Puyb/powermeter/README.md

Do It Yourself (DIY) Cycle Power Meter

Based on https://gitlab.com/tbressers/power/ with a custom PCB in the hardware folder

---

Original README:

This is the code for a crank-based power meter, transmitting over BLE to a bike computer. The whole project is based on Steve Jarvis website/gitlab with a nice set of improvements (see gitlab link below) and tested on a 'Adafruit Bluefruit nRF52840 Feather Express' board.

Please find the complete DIY work-instruction here:

https://gitlab.com/tbressers/power/-/wikis/home

Best regards,
Thijs
