Puyb/powermeter/hardware/Datasheets.md

[Seeedstudio XIA BLE](https://wiki.seeedstudio.com/XIAO_BLE/)

[Seeedstudio XIA BLE schematics](https://files.seeedstudio.com/wiki/XIAO-BLE/Seeed-Studio-XIAO-nRF52840-Sense-v1.1.pdf)

[nRF52840](https://files.seeedstudio.com/wiki/XIAO-BLE/nRF52840_PS_v1.5.pdf)

[HX711](https://cdn.sparkfun.com/datasheets/Sensors/ForceFlex/hx711_english.pdf)

[MPU-6050](https://invensense.tdk.com/wp-content/uploads/2015/02/MPU-6000-Datasheet1.pdf)

[MPU-6050 Register map](https://invensense.tdk.com/wp-content/uploads/2015/02/MPU-6000-Register-Map1.pdf)

[LSM6DS3TR-C](https://datasheet.lcsc.com/lcsc/2102261805_STMicroelectronics-LSM6DS3TR-C_C967633.pdf)
