Puyb/powermeter/hardware/powermeter.pdf

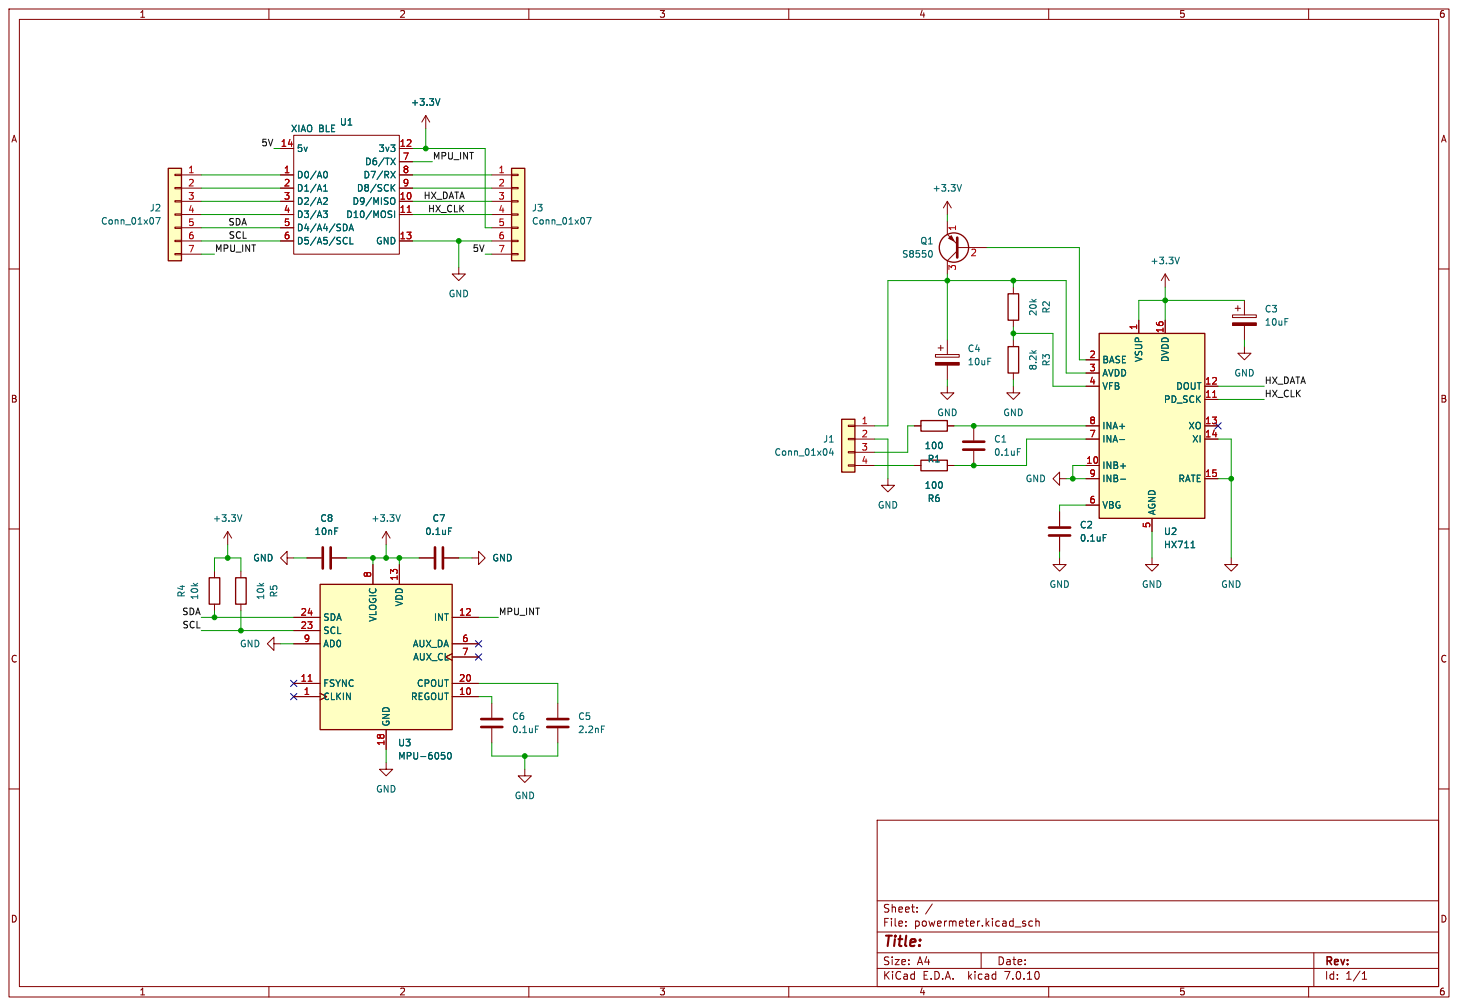
[picture p1: page 1]

Id: 1/1 Title: File: powermeter.kicad_sch Sheet: /
