Puyb/powermeter/hardware/powermeter.kicad_pcb

## KiCad design hardware/powermeter.kicad_pcb (2024-01-20)

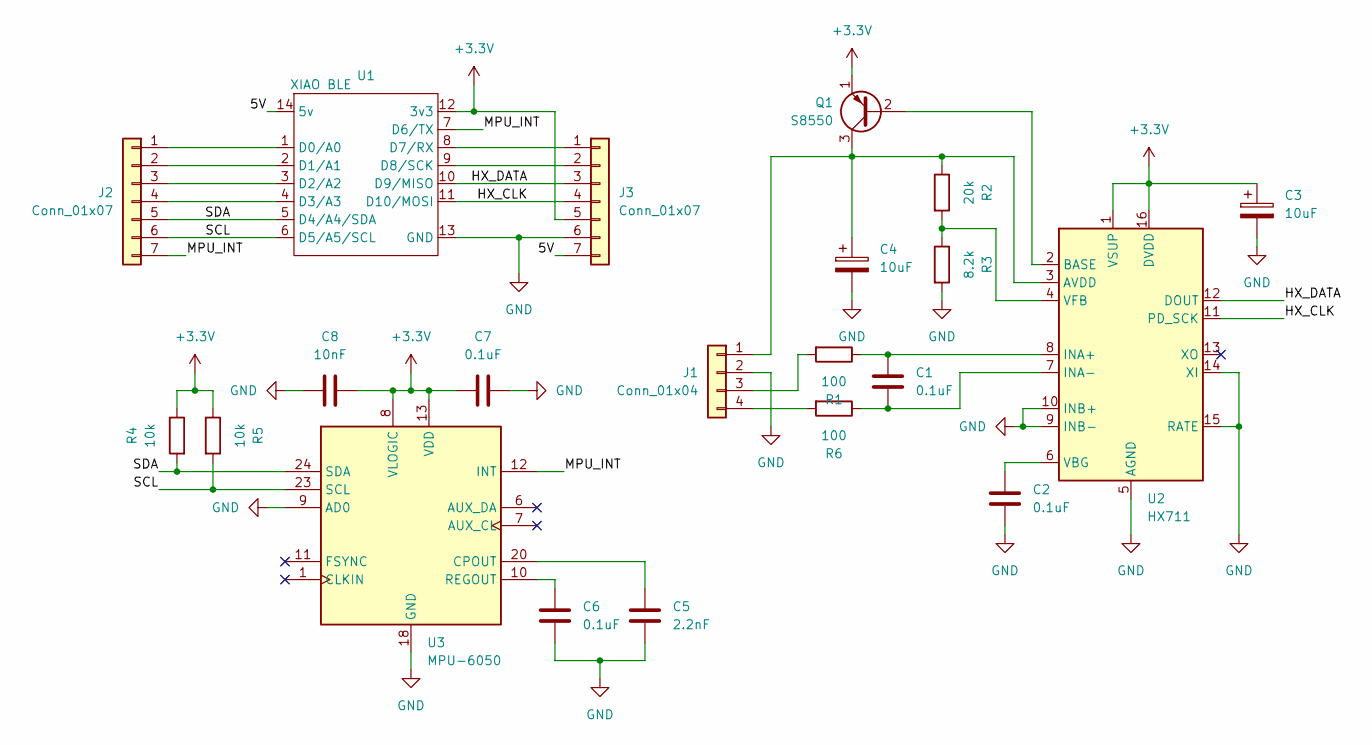
[picture p2: schematic powermeter.kicad_sch]

Parts:
C1, C2, C6, C7: 0.1uF; C_0402_1005Metric; LCSC C1525
C3, C4: 10uF; C_0402_1005Metric; LCSC C15525
C5: 2.2nF; C_0402_1005Metric; LCSC C1604
C8: 10nF; C_0402_1005Metric; LCSC C15195
J1: Conn_01x04; connecteur
J2, J3: Conn_01x07; PinHeader_1x07_P2.54mm_Vertical
Q1: S8550; SOT-23; LCSC C105432
R1, R6: 100; R_0402_1005Metric; LCSC C25076
R2: 20k; R_0402_1005Metric; LCSC C25765
R3: 8.2k; R_0402_1005Metric; LCSC C2906967
R4, R5: 10k; R_0402_1005Metric; LCSC C25744
U1: XIAO BLE; MOUDLE16P-SMD-2.54-21X17.8MM
U2: HX711; SOP-16_3.9x9.9mm_P1.27mm; LCSC C6705483
U3: MPU-6050; InvenSense_QFN-24_4x4mm_P0.5mm; LCSC C24112

Connections:
+3.3V: C3.1, C7.1, C8.1, J3.5, Q1.1 (E), R4.1, R5.1, U1.12 (3v3), U2.1 (VSUP), U2.16 (DVDD), U3.8 (VLOGIC), U3.13 (VDD)
/5V: J3.7, U1.14 (5v)
/HX_CLK: J3.4, U1.11 (D10/MOSI), U2.11 (PD_SCK)
/HX_DATA: J3.3, U1.10 (D9/MISO), U2.12 (DOUT)
/MPU_INT: J2.7, U1.7 (D6/TX), U3.12 (INT)
/SCL: J2.6, R5.2, U1.6 (D5/A5/SCL), U3.23 (SCL)
/SDA: J2.5, R4.2, U1.5 (D4/A4/SDA), U3.24 (SDA)
GND: C2.2, C3.2, C4.2, C5.2, C6.2, C7.2, C8.2, J1.2, J3.6, R3.2, U1.13 (GND), U2.5 (AGND), U2.9 (INB-), U2.10 (INB+), U2.14 (XI), U2.15 (RATE), U3.9 (AD0), U3.18 (GND)
unnamed: C4.1, J1.1, Q1.3 (C), R2.1, U2.3 (AVDD)
unnamed: J1.3, R1.2
unnamed: J1.4, R6.2
unnamed: J2.1, U1.1 (D0/A0)
unnamed: J2.2, U1.2 (D1/A1)
unnamed: J2.3, U1.3 (D2/A2)
unnamed: J2.4, U1.4 (D3/A3)
unnamed: J3.1, U1.8 (D7/RX)
unnamed: J3.2, U1.9 (D8/SCK)
unnamed: Q1.2 (B), U2.2 (BASE)
unnamed: C1.1, R1.1, U2.8 (INA+)
unnamed: C1.2, R6.1, U2.7 (INA-)
unnamed: C2.1, U2.6 (VBG)
unnamed: R2.2, R3.1, U2.4 (VFB)
unnamed: C5.1, U3.20 (CPOUT)
unnamed: C6.1, U3.10 (REGOUT)

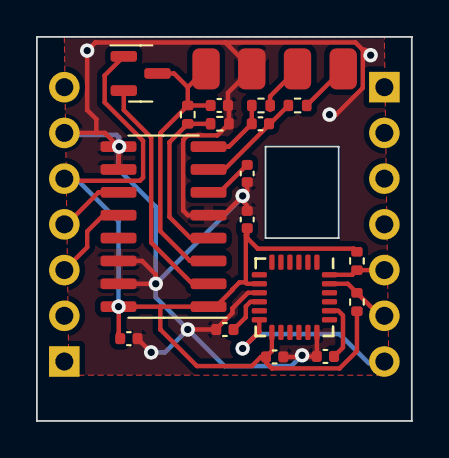
[picture p3: board powermeter.kicad_pcb from above]

Board: 2 copper layers, 20.8 x 21.3 mm, 21 parts (1 on the bottom side), 24 nets.
