Puyb/powermeter/(commit log)

2021-11-05 Initial commit, copied files from Steve Jarvis and added sleep mode for Feather Express boards https://iamteapot.dev/homemade-power-meter/ https://gitlab.com/sjarvis/powermeter
    TODO:
    - Cleanup code
    - Integrate calibration
    - Many more things!
2021-11-12 Added sleep and wake-up, and started the semi- automatic calibration implementation
2021-11-12 Sleep / wake-up and semi-automatic calibration
2021-11-16 Upgrade to latest board and library versions
2021-11-19 Calibration via bluetooth (Bluefruit LE connect App)
2021-11-21 Added storage of calibration factor in UICR on nRF52840 (feather)
2021-11-26 Fixed calibration saving to nvram (flash)
    [calibrate.ino, power.ino]
2021-12-13 Interrupt driven load cell reading
2021-12-17 Fixed kg to Newtons
    [gyro.ino, load_cell.ino, power.ino]
2021-12-17 Fixed battery reading
2021-12-18 abs power and smart calibration
2021-12-28 Workaround for load-sensor calibration/read-out
    [calibrate.ino, load_cell.ino, power.ino]
2021-12-29 Calibration fix/workaround
2021-12-29 Fixed calibration values saving
    [calibrate.ino, load_cell.ino]
2021-12-29 Fixed calibrations value saving
2021-12-30 Properly fixed x2 issue
    [calibrate.ino, power.ino]
2022-01-12 Fixed cadence and increased measurement robustness
    [gyro.ino, power.ino]
2022-01-12 Added temperature and session stats
2022-01-27 Gyroscope-speed based cadence measurements
2023-12-28 First version
    [powermeter-CuBottom.gbr, powermeter-CuTop.gbr, powermeter-EdgeCuts.gbr, powermeter-MaskBottom.gbr, powermeter-MaskTop.gbr, powermeter-NPTH.drl, powermeter-PTH.drl, powermeter-PasteBottom.gbr]
2023-12-28 Fix 5v-GND short. Minor tweaks on layout
    [powermeter.kicad_pcb, powermeter.kicad_sch]
2024-01-20 Fix AD0 MPU6050 to GND
    [powermeter.kicad_pcb, powermeter.kicad_sch]
2024-01-21 Move kicad files to hardware
    [powermeter-CuBottom.gbr, powermeter-CuTop.gbr, powermeter-EdgeCuts.gbr, powermeter-MaskBottom.gbr, powermeter-MaskTop.gbr, powermeter-NPTH.drl, powermeter-PTH.drl, powermeter-PasteBottom.gbr]
2024-01-21 Add schematics PDF and JLCPCB files
    [BOM-powermeter.csv, powermeter.kicad_sch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]
2024-01-21 Update JLCPCB files
    [BOM-powermeter.csv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]
